r0b0t1cu/RC2014-Turbo-Sound/docs/README.md

# Documentation

- [Schematic PDF](schematic.pdf)
- [Photograph of the assembled board](images/turbosound-board-photo.jpg)
- [Top-side board render](images/board-top.png)
- [Bottom-side board render and silkscreen legend](images/board-bottom.png)
- [Interactive bill of materials](ibom.html)
- [Jumper settings](JUMPER_SETTINGS.md)
