r0b0t1cu/RC2014-Turbo-Sound/docs/images/board-bottom.png

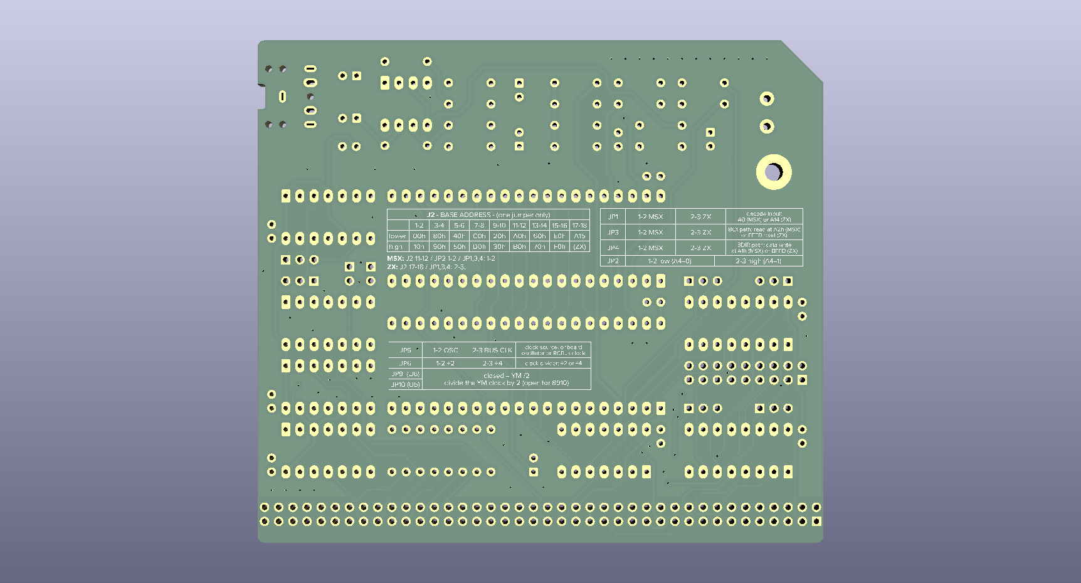
docs/images/board-bottom.png
