r0b0t1cu/RC2014-Turbo-Sound/docs/images/board-top.png

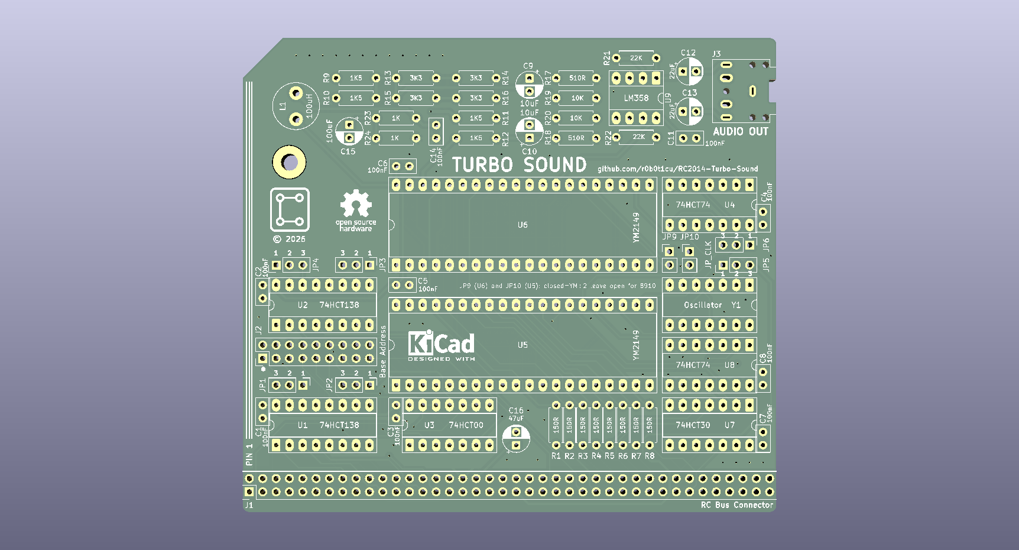
docs/images/board-top.png
