r0b0t1cu/RC2014-Turbo-Sound/docs/schematic.pdf

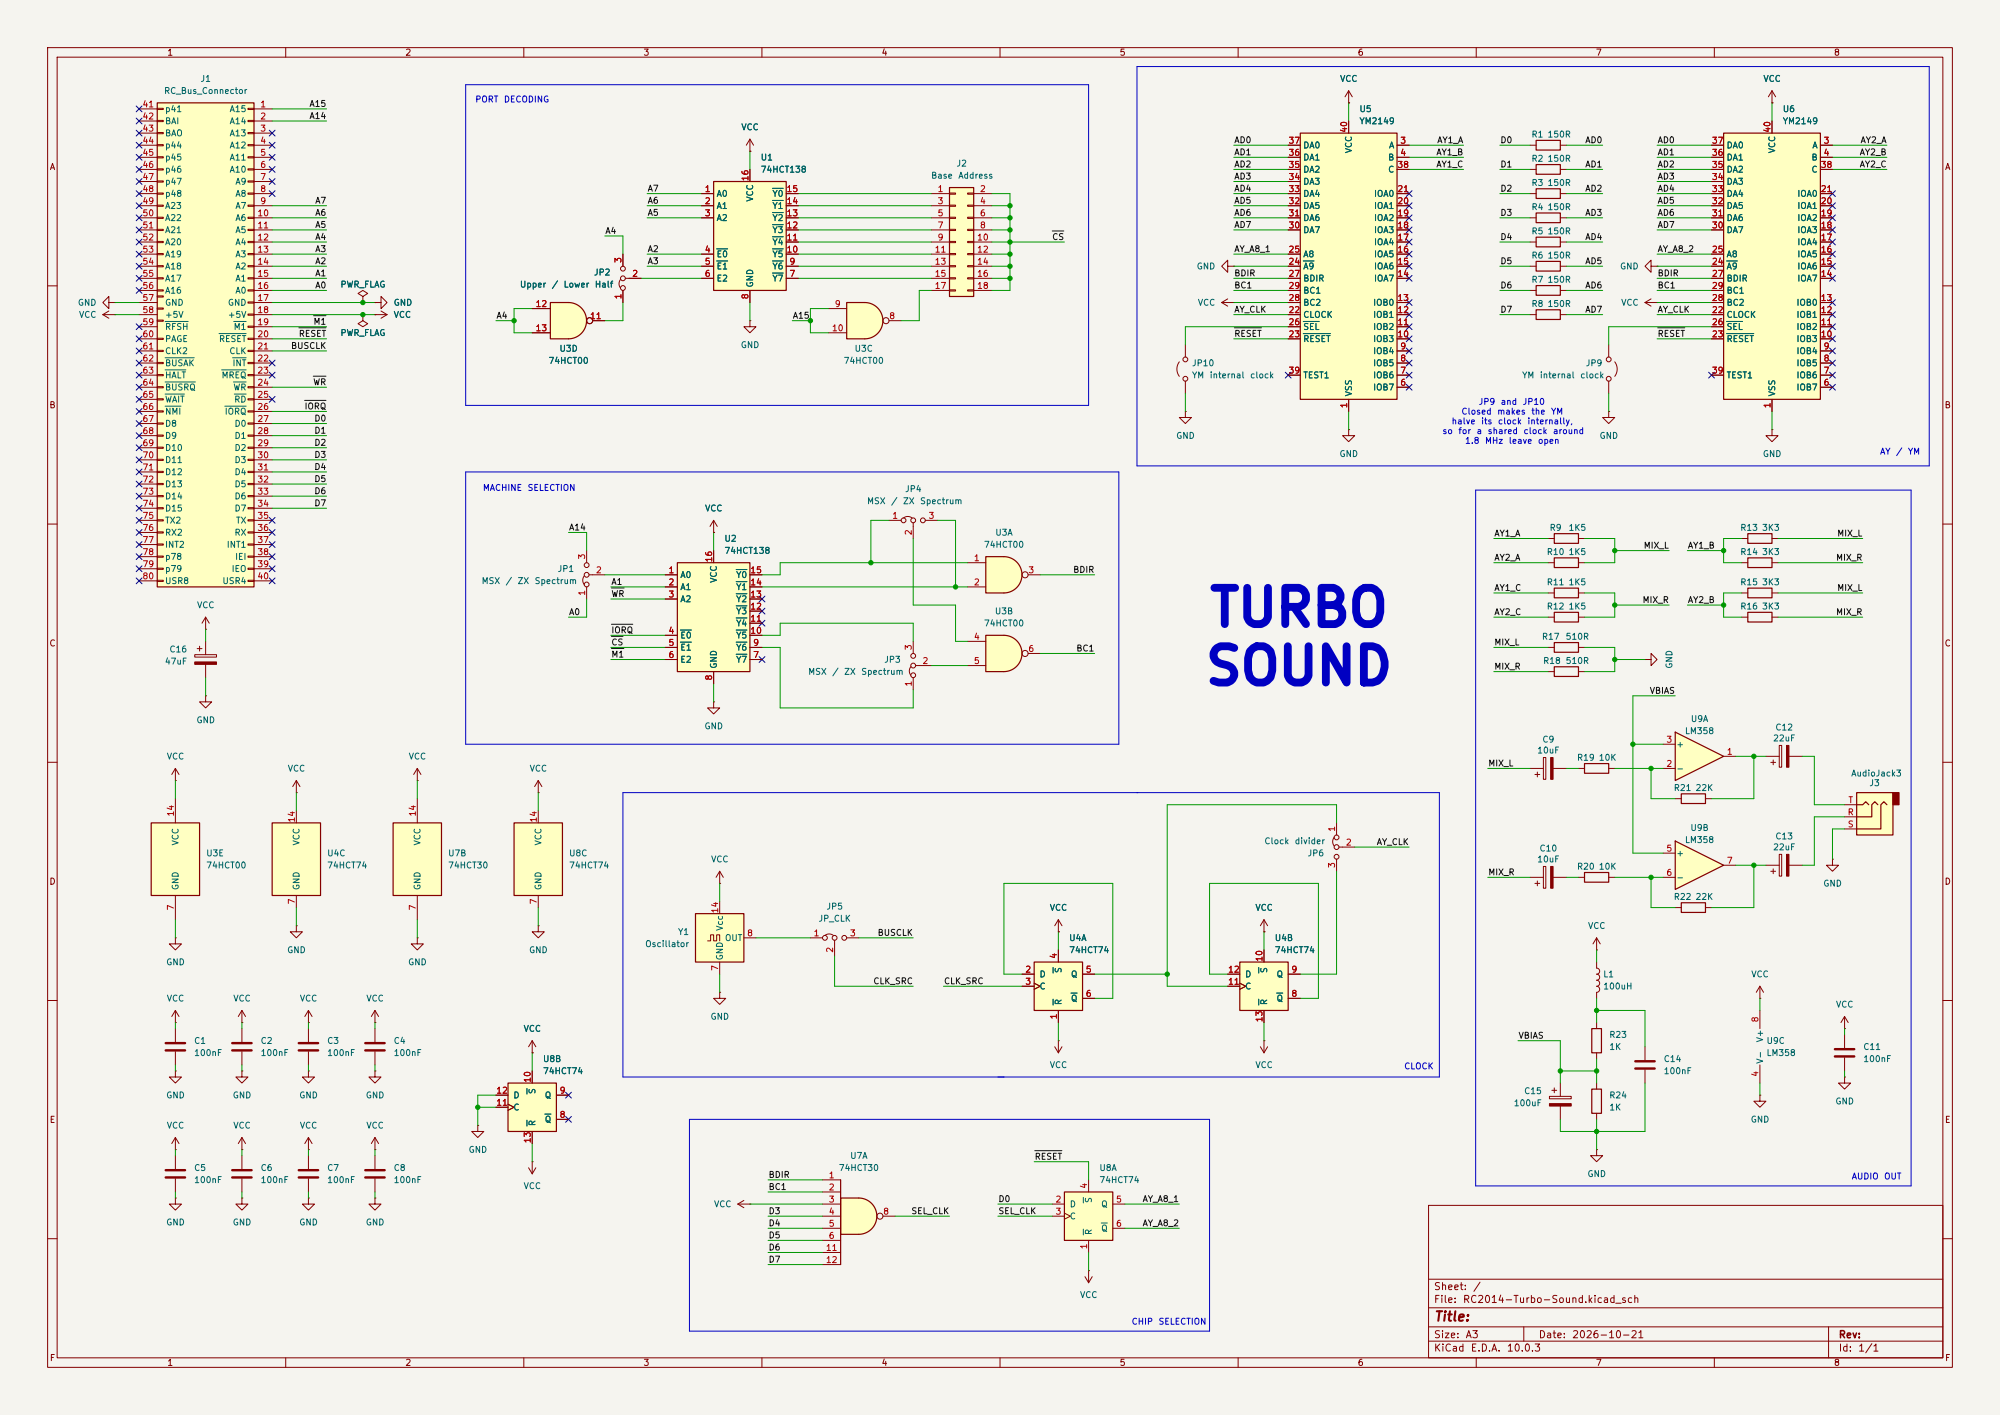
[picture p4: page 1]

PORT DECODING MACHINE SELECTION

JP9 and JP10 Closed makes the YM

halve its clock internally, so for a shared clock around 1.8 MHz leave open

CHIP SELECTION

Size: A3 | Rev: | F Date: 2026-10-21
KiCad E.D.A. 10.0.3 | Id: 1/1
