r0b0t1cu/RC2014-Turbo-Sound/RC2014-Turbo-Sound-KiCad/RC2014-Turbo-Sound-KiCad.kicad_pcb

## KiCad design RC2014-Turbo-Sound-KiCad/RC2014-Turbo-Sound-KiCad.kicad_pcb (2026-11-07)

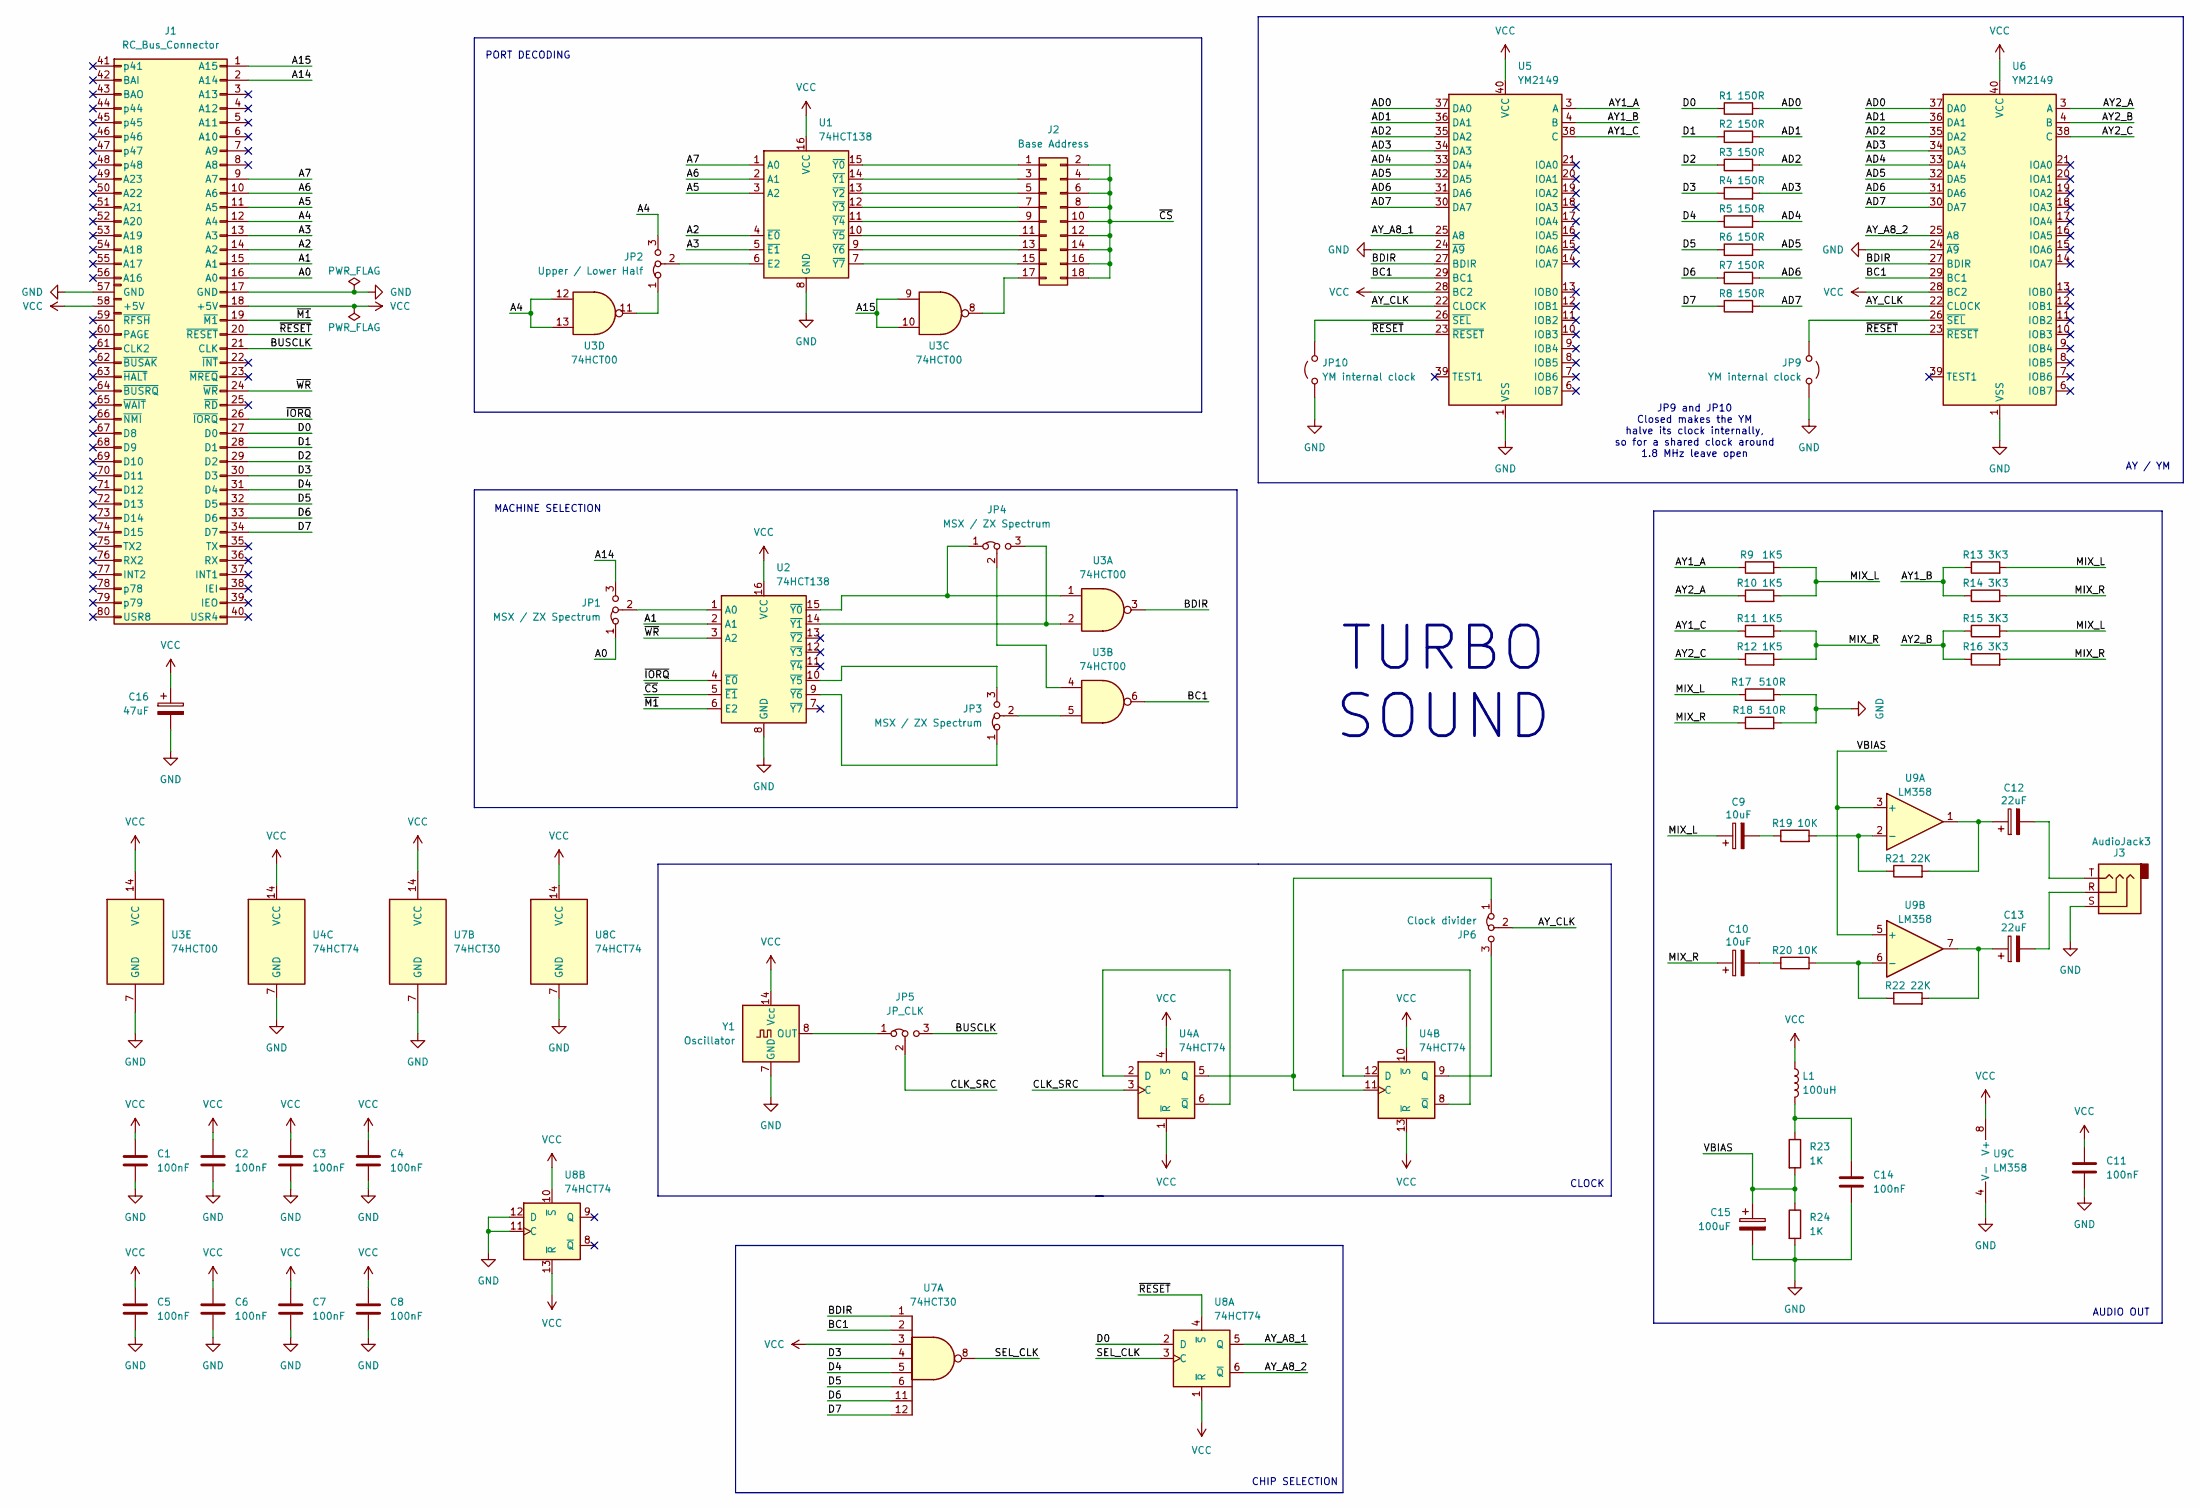
[picture p5: schematic RC2014-Turbo-Sound-KiCad.kicad_sch]

Parts:
C1, C2, C3, C4, C5, C6, C7, C8, C11, C14: 100nF; C_Disc_D5.0mm_W2.5mm_P2.50mm
C9, C10: 10uF; CP_Radial_D5.0mm_P2.50mm
C12, C13: 22uF; CP_Radial_D5.0mm_P2.50mm
C15: 100uF; CP_Radial_D5.0mm_P2.50mm
C16: 47uF; CP_Radial_D5.0mm_P2.50mm
J1: RC_Bus_Connector; PinHeader_2x40_P2.54mm_Vertical
J2: Base Address; PinHeader_2x09_P2.54mm_Vertical
J3: AudioJack3; Jack_3.5mm_CUI_SJ1-3525N_Horizontal
JP1, JP3, JP4: MSX / ZX Spectrum; PinHeader_1x03_P2.54mm_Vertical
JP2: Upper / Lower Half; PinHeader_1x03_P2.54mm_Vertical
JP5: JP_CLK; PinHeader_1x03_P2.54mm_Vertical
JP6: Clock divider; PinHeader_1x03_P2.54mm_Vertical
JP9, JP10: YM internal clock; PinHeader_1x02_P2.54mm_Vertical
L1: 100uH; L_Radial_D8.7mm_P5.00mm_Fastron_07HCP
R1, R2, R3, R4, R5, R6, R7, R8: 150R; R_Axial_DIN0207_L6.3mm_D2.5mm_P7.62mm_Horizontal
R9, R10, R11, R12: 1K5; R_Axial_DIN0207_L6.3mm_D2.5mm_P7.62mm_Horizontal
R13, R14, R15, R16: 3K3; R_Axial_DIN0207_L6.3mm_D2.5mm_P7.62mm_Horizontal
R17, R18: 510R; R_Axial_DIN0207_L6.3mm_D2.5mm_P7.62mm_Horizontal
R19, R20: 10K; R_Axial_DIN0207_L6.3mm_D2.5mm_P7.62mm_Horizontal
R21, R22: 22K; R_Axial_DIN0207_L6.3mm_D2.5mm_P7.62mm_Horizontal
R23, R24: 1K; R_Axial_DIN0207_L6.3mm_D2.5mm_P7.62mm_Horizontal
U1, U2: 74HCT138; DIP-16_W7.62mm_Socket_LongPads
U3: 74HCT00; DIP-14_W7.62mm_Socket_LongPads
U4, U8: 74HCT74; DIP-14_W7.62mm_Socket_LongPads
U5, U6: YM2149; DIP-40_W15.24mm_Socket_LongPads
U7: 74HCT30; DIP-14_W7.62mm_Socket_LongPads
U9: LM358; DIP-8_W7.62mm_Socket_LongPads
Y1: Oscillator; DIP-14_W7.62mm_Socket_LongPads

Connections:
/A0: J1.16 (A0), JP1.1 (A)
/A1: J1.15 (A1), U2.2 (A1)
/A2: J1.14 (A2), U1.4 (~E0)
/A3: J1.13 (A3), U1.5 (~E1)
/A4: J1.12 (A4), JP2.3 (B), U3.12, U3.13
/A5: J1.11 (A5), U1.3 (A2)
/A6: J1.10 (A6), U1.2 (A1)
/A7: J1.9 (A7), U1.1 (A0)
/A14: J1.2 (A14), JP1.3 (B)
/A15: J1.1 (A15), U3.9, U3.10
/AD0: R1.2, U5.37 (DA0), U6.37 (DA0)
/AD1: R2.2, U5.36 (DA1), U6.36 (DA1)
/AD2: R3.2, U5.35 (DA2), U6.35 (DA2)
/AD3: R4.2, U5.34 (DA3), U6.34 (DA3)
/AD4: R5.2, U5.33 (DA4), U6.33 (DA4)
/AD5: R6.2, U5.32 (DA5), U6.32 (DA5)
/AD6: R7.2, U5.31 (DA6), U6.31 (DA6)
/AD7: R8.2, U5.30 (DA7), U6.30 (DA7)
/AY1_A: R9.1, U5.3 (A)
/AY1_B: R13.1, R14.1, U5.4 (B)
/AY1_C: R11.1, U5.38 (C)
/AY2_A: R10.1, U6.3 (A)
/AY2_B: R15.1, R16.1, U6.4 (B)
/AY2_C: R12.1, U6.38 (C)
/AY_A8_1: U5.25 (A8), U8.5 (Q)
/AY_A8_2: U6.25 (A8), U8.6 (~Q)
/AY_CLK: JP6.2 (C), U5.22 (CLOCK), U6.22 (CLOCK)
/BC1: U3.6, U5.29 (BC1), U6.29 (BC1), U7.2
/BDIR: U3.3, U5.27 (BDIR), U6.27 (BDIR), U7.1
/BUSCLK: J1.21 (CLK), JP5.3 (B)
/CLK_SRC: JP5.2 (C), U4.3 (C)
/D0: J1.27 (D0), R1.1, U8.2 (D)
/D1: J1.28 (D1), R2.1
/D2: J1.29 (D2), R3.1
/D3: J1.30 (D3), R4.1, U7.4
/D4: J1.31 (D4), R5.1, U7.5
/D5: J1.32 (D5), R6.1, U7.6
/D6: J1.33 (D6), R7.1, U7.11
/D7: J1.34 (D7), R8.1, U7.12
/MIX_L: C9.1, R9.2, R10.2, R13.2, R15.2, R17.1
/MIX_R: C10.1, R11.2, R12.2, R14.2, R16.2, R18.1
/SEL_CLK: U7.8, U8.3 (C)
/VBIAS: C15.1, R23.2, R24.1, U9.3 (+), U9.5 (+)
/~CS: J2.2, J2.4, J2.6, J2.8, J2.10, J2.12, J2.14, J2.16, J2.18, U2.5 (~E1)
/~IORQ: J1.26 (~IORQ), U2.4 (~E0)
/~M1: J1.19 (~M1), U2.6 (E2)
/~RESET: J1.20 (~RESET), U5.23 (~RESET), U6.23 (~RESET), U8.4 (~S)
/~WR: J1.24 (~WR), U2.3 (A2)
GND: C1.2, C2.2, C3.2, C4.2, C5.2, C6.2, C7.2, C8.2, C11.2, C14.2, C15.2, C16.2, J1.17 (GND), J1.57 (GND), J3.S, JP9.1 (A), JP10.1 (A), R17.2, R18.2, R24.2, U1.8 (GND), U2.8 (GND), U3.7 (GND), U4.7 (GND), U5.1 (VSS), U5.24 (~A9), U6.1 (VSS), U6.24 (~A9), U7.7 (GND), U8.7 (GND), U8.11 (C), U8.12 (D), U9.4 (V-), Y1.4, Y1.7 (GND)
unnamed: C9.2, R19.1
unnamed: C10.2, R20.1
unnamed: C12.1, R21.2, U9.1
unnamed: C12.2, J3.T, J3.TN
unnamed: C13.1, R22.2, U9.7
unnamed: C13.2, J3.R, J3.RN
unnamed: C14.1, L1.2, R23.1
unnamed: J2.1, U1.15 (~Y0)
unnamed: J2.3, U1.14 (~Y1)
unnamed: J2.5, U1.13 (~Y2)
unnamed: J2.7, U1.12 (~Y3)
unnamed: J2.9, U1.11 (~Y4)
unnamed: J2.11, U1.10 (~Y5)
unnamed: J2.13, U1.9 (~Y6)
unnamed: J2.15, U1.7 (~Y7)
unnamed: J2.17, U3.8
unnamed: JP1.2 (C), U2.1 (A0)
unnamed: JP2.1 (A), U3.11
unnamed: JP2.2 (C), U1.6 (E2)
unnamed: JP3.1 (A), U2.9 (~Y6)
unnamed: JP3.3 (B), U2.10 (~Y5)
unnamed: JP3.2 (C), U3.5
unnamed: JP4.1 (A), U2.15 (~Y0), U3.1
unnamed: JP4.3 (B), U2.14 (~Y1), U3.2
unnamed: JP4.2 (C), U3.4
unnamed: JP5.1 (A), Y1.8 (OUT), Y1.11
unnamed: JP6.1 (A), U4.5 (Q), U4.11 (C)
unnamed: JP6.3 (B), U4.9 (Q)
unnamed: JP9.2 (B), U6.26 (~SEL)
unnamed: JP10.2 (B), U5.26 (~SEL)
unnamed: U4.2 (D), U4.6 (~Q)
unnamed: U4.8 (~Q), U4.12 (D)
unnamed: R19.2, R21.1, U9.2 (-)
unnamed: R20.2, R22.1, U9.6 (-)
VCC: C1.1, C2.1, C3.1, C4.1, C5.1, C6.1, C7.1, C8.1, C11.1, C16.1, J1.18 (+5V), J1.58 (+5V), L1.1, U1.16 (VCC), U2.16 (VCC), U3.14 (VCC), U4.1 (~R), U4.4 (~S), U4.10 (~S), U4.13 (~R), U4.14 (VCC), U5.28 (BC2), U5.40 (VCC), U6.28 (BC2), U6.40 (VCC), U7.3, U7.14 (VCC), U8.1 (~R), U8.10 (~S), U8.13 (~R), U8.14 (VCC), U9.8 (V+), Y1.14 (Vcc)

Notes on the sheet:
AUDIO OUT
AY / YM
PORT DECODING
CHIP SELECTION
TURBO SOUND
JP9 and JP10 Closed makes the YM halve its clock internally, so for a shared clock around 1.8 MHz leave open
MACHINE SELECTION
CLOCK

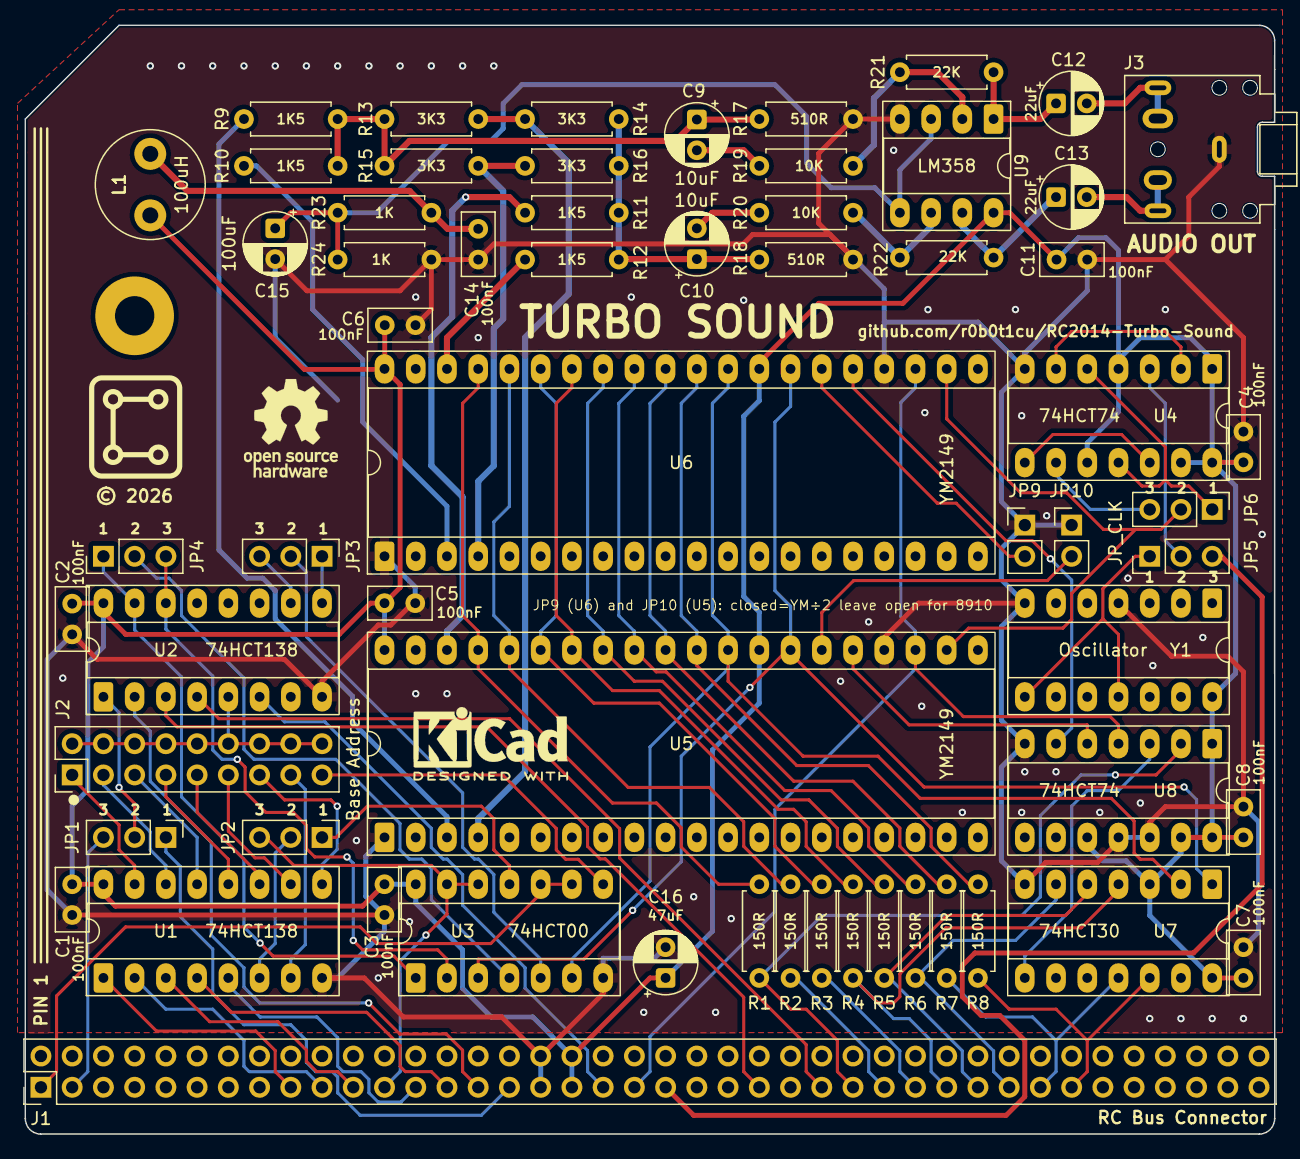
[picture p6: board RC2014-Turbo-Sound-KiCad.kicad_pcb from above]

Board: 2 copper layers, 101.6 x 90.2 mm, 62 parts (0 on the bottom side), 84 nets.
