r0b0t1cu/RC2014-Turbo-Sound/(commit log)

2026-11-07 Prepare RC2014 Turbo Sound hardware release
    [RC2014-Turbo-Sound-KiCad.kicad_pcb, RC2014-Turbo-Sound-KiCad.kicad_sch, RC2014-Turbo-Sound.kicad_pcb_bom.csv, RC2014-Turbo-Sound.kicad_pcb_positions.csv]
2026-11-07 Add assembled board photo to README
