r0b0t1cu/RC2014-Turbo-Sound/(notices)

Notices in the files:
RC2014-Turbo-Sound-KiCad/RC2014-Turbo-Sound-KiCad.kicad_pcb:
© 2026
